aravinth41/ECG_BLE/01_Project Inputs/WhatsApp Image 2020-04-03 at 2.52.47 PM.jpeg

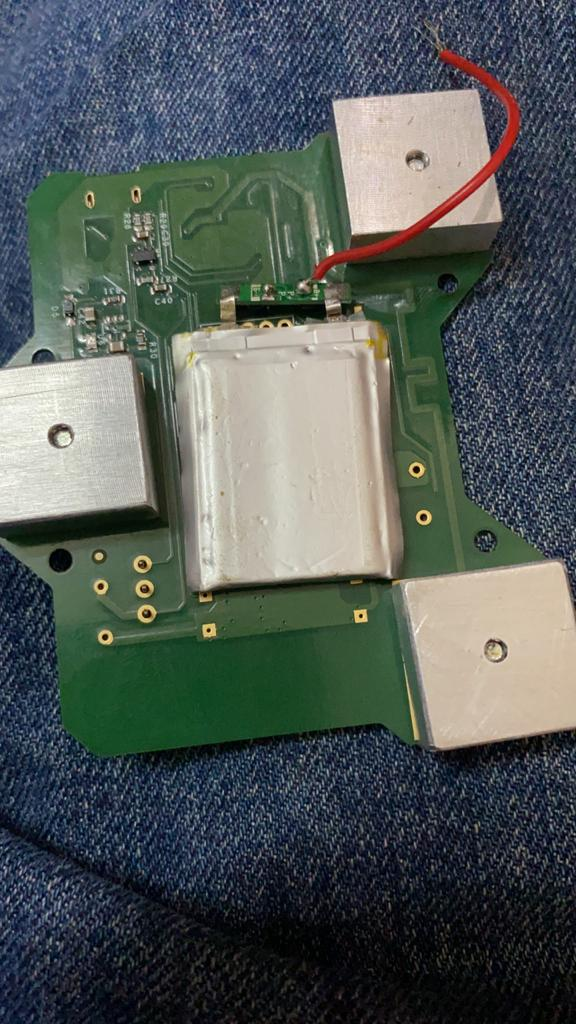
01_Project Inputs/WhatsApp Image 2020-04-03 at 2.52.47 PM.jpeg
