aravinth41/ECG_BLE/07_Mechanical/ECG BLE Mechanical requirement V10.pptx

## ECG BLE Mechanical Requirement

09-April-2020

## Old board design


PCB Bottom


PCB Top

## Old board design

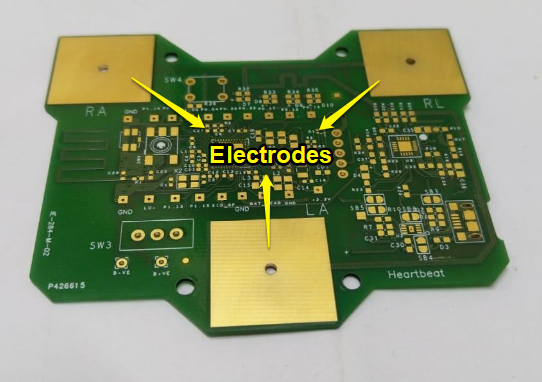
[picture p3: figure]
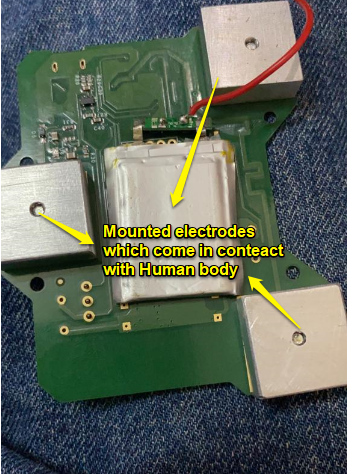
[picture p4: figure]

## New board requirement

PCB Diameter 42mm

## New board requirement

Note: Temperature sensor to be added and yet to plan
on the position.

PCB Diameter 42mm

Opening required for casing in
The dotted areas

## New board requirement

PCB Diameter 42mm

Opening for Micro B USB
Connector

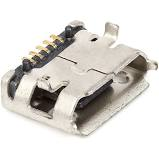
[picture p5: figure]

Note: Yet to decide on USB connector position

## New board requirement

PCB Diameter 42mm

3 Electrodes will be mounted in
the dotted region.
Something similar to this.

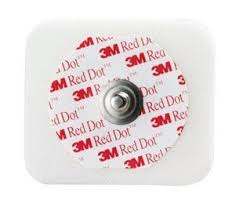
[picture p6: figure]

Note: Yet to decide the electrode part

## New board requirement

Bottom view

PCB

On board connector
PCB mount

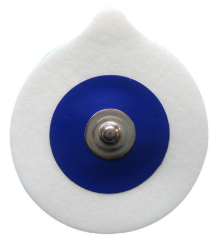
[picture p7: figure]

Note: Yet to decide the electrode part

Mating electrode

## New board requirement

Bottom view with no electrode mounted

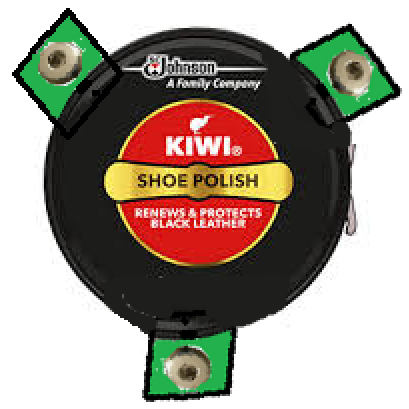
[picture p8: figure]

Over all product looks like a Shoe
Polish tin. Something like this with
the electrode stickers, which will
have contact with Human body.

Bottom view with electrode mounted

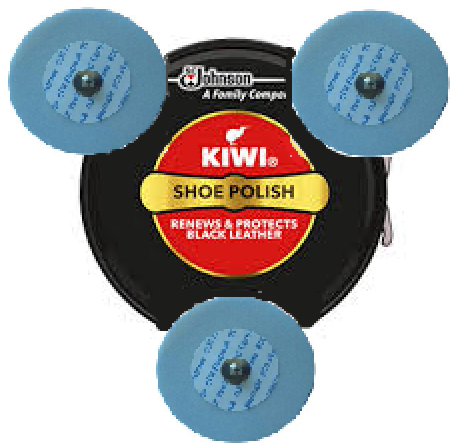
[picture p9: figure]

LA

LA

RA

RA

RL/LL

RL/LL
