aravinth41/ECG_BLE/03_Output/02_Assembly/ECG_BLE_Bill_Of_Materials_V1_PCBA.xlsx

Component list |  |  |  |  |  | Project: | ECG_BLE.PrjPcb
 |  |  | Board Name: | ECG_BLE.PCBA
 |  |  | Revision: | Rev1.0
 |  |  | Author: | Sandeep G
 |  |  | Report Date: | 08-May-20 | 2:30:41 AM
 |  |  | Print Date: | 2020-06-26 | 12:34:22
Item | Quantity | Designator | Description | Manufacturer | Manufacturer Part Number | Vendor Name | Vendor Part Number | Mouting State
1 | 2 | C1, C2 | CAP CER 0.33UF 10V X5R 0402 | Samsung Electro-Mechanics | CL05A334KP5NNNC | Digi-Key | 1276-6665-1-ND | Fitted
2 | 1 | C3 | CAP CER 1000PF 50V X7R 0402 | KEMET | C0402C102J5RACTU | Digi-Key | 399-7754-1-ND | Fitted
3 | 8 | C4, C5, C11, C12, C24, C25, C29, C35 | CAP CER 0.1UF 16V X7R 0402 | Samsung Electro-Mechanics America, Inc. | CL05B104KO5NNNC | Digi-Key | 1276-1001-1-ND | Fitted
4 | 1 | C6 | CAP CER 10000PF 50V X7R 0402 | Samsung Electro-Mechanics America, Inc. | C0402C103J5RACTU | Digi-Key | 399-7758-1-ND | Fitted
5 | 1 | C7 | CAP CER 1500PF 50V X7R 0402 | Yageo | CC0402JRX7R9BB152 | Digi-Key | 311-3763-1-ND | Fitted
6 | 4 | C9, C10, C30, C31 | CAP CER 1UF 16V X5R 0402 | Samsung Electro-Mechanics | CL05A105KO5NNNC | Digi-Key | 1276-1067-1-ND | Fitted
7 | 4 | C13, C14, C15, C17 | CAP CER 12PF 50V C0G/NP0 0402 | KEMET | CBR04C120J5GAC | Digi-Key | 399-6169-1-ND | Fitted
8 | 1 | C16 | CAP CER 100PF 25V C0G/NP0 0402 | KEMET | C0402C101J3GACTU | Digi-Key | 399-1022-1-ND | Fitted
9 | 2 | C19, C20 | CAP CER 1PF 50V C0G/NP0 0402 | Samsung Electro-Mechanics | CL05C010CB5NNNC | Digi-Key | 1276-1595-1-ND | Fitted
10 | 1 | C21 | CAP CER 820PF 50V C0G/NP0 0402 | Samsung Electro-Mechanics | CL05C821JB5NNNC | Digi-Key | 1276-1727-1-ND | Fitted
11 | 3 | C22, C23, C26 | CAP CER 4.7UF 6.3V X5R 0402 | Murata Electronics North America | GRM155R60J475ME47D | Digi-Key | 490-5915-1-ND | Fitted
12 | 2 | C27, C28 | CAP CER 10UF 10V X5R 0402 | Samsung Electro-Mechanics America, Inc. | CL05A106MP5NUNC | DigiKey | 1276-1450-1-ND | Fitted
13 | 1 | C32 | CAP CER 1.5PF 50V NP0 0402 | Murata Electronics | GJM1555C1H1R5CB01D‎ | Digi-Key | 490-3087-1-ND‎ | Fitted
14 | 1 | D1 | LED GREEN/RED CLEAR 1204 SMD R/A | Bivar Inc. | SM1204BC | Digi-Key | 492-1228-1-ND | Fitted
15 | 1 | D3 | LED BLUE CLEAR 2SMD | Kingbright | APT1608LVBC/D | Digi-Key | 754-1933-1-ND | Fitted
16 | 1 | D4 | LED GREEN CLEAR SMD | Würth Elektronik | 150060VS75000‎ | Digi-Key | ‎732-4980-1-ND‎ | Fitted
17 | 1 | J2 | CONN HOUSING PH 2POS 2MM WHITE | JST Sales America Inc. | S2B-PH-K-S(LF)(SN) | Digi-Key | 455-1719-ND | Fitted
18 | 1 | J3 | CONN USB MICRO B RECPT SMT R/A | Amphenol FCI | 10118194-0001LF | Digi-Key | 609-4618-1-ND | Fitted
19 | 1 | L1 | FIXED IND 3.9NH 170MA 500 MOHM | Murata Electronics North America | LQP15MN3N9B02D | Digi-Key | 490-1131-1-ND | Fitted
20 | 1 | R1 | RES 1.4M OHM 1% 1/16W 0402 | Stackpole Electronics Inc | RMCF0402FT1M40 | Digi-Key | RMCF0402FT1M40CT-ND | Fitted
21 | 6 | R2, R3, R4, R5, R9, R11 | RES SMD 10M OHM 5% 1/10W 0402 | Panasonic Electronic Components | ERJ-2GEJ106X | Digi-Key | P10MJCT-ND | Fitted
22 | 6 | R6, R12, R17, R19, R21, R38 | RES SMD 0.0OHM JUMPER 1/10W 0402 | Panasonic Electronic Components | ERJ-2GE0R00X | Digi-Key | P0.0JCT-ND | Fitted
23 | 2 | R7, R10 | RES SMD 180K OHM 1% 1/16W 0402 | Yageo | RC0402FR-07180KL | Digi-Key | 311-180KLRCT-ND | Fitted
24 | 1 | R13 | RES SMD 360K OHM 1% 1/10W 0402 | Panasonic Electronic Components | ERJ-2RKF3603X | Digi-Key | P360KLCT-ND | Fitted
25 | 3 | R15, R16, R20 | RES SMD 1M OHM 1% 1/10W 0402 | Panasonic Electronic Components | ERJ-2RKF1004X | Digi-Key | P1.00MLCT-ND | Fitted
26 | 3 | R18, R23, R30 | RES SMD 100K OHM 1% 1/10W 0402 | Panasonic Electronic Components | ERJ-2RKF1003X | Digi-Key | P100KLCT-ND | Fitted
27 | 2 | R24, R27 | RES SMD 10K OHM 1% 1/10W 0402 | Panasonic Electronic Components | ERJ-2RKF1002X | Digi-Key | P10.0KLCT-ND | Fitted
28 | 1 | R22 | RES SMD 4.7K OHM 5% 1/10W 0402 | Panasonic Electronic Components | ERJ-2GEJ472X | Digi-Key | P4.7KJCT-ND | Fitted
29 | 2 | R25, R26 | RES SMD 1.5K OHM 1% 1/10W 0402 | Panasonic Electronic Components | ERJ-2RKF1501X | Digi-Key | P1.50KLCT-ND | Fitted
30 | 1 | R28 | RES SMD 16.5K OHM 1% 1/10W 0402 | Panasonic Electronic Components | ERJ-2RKF1652X | Digi-Key | P16.5KLCT-ND | Fitted
31 | 1 | R29 | RES SMD 13.3K OHM 1% 1/10W 0402 | Panasonic Electronic Components | ERJ-2RKF1332X | Digi-Key | P13.3KLCT-ND | Fitted
32 | 1 | R31 | RES SMD 470 OHM 1% 1/10W 0402 | Panasonic Electronic Components | ERJ-2RKF4700X | Digi-Key | P470LCT-ND | Fitted
33 | 1 | R32 | RES SMD 1K OHM 1% 1/10W 0402 | Panasonic Electronic Components | ERJ-2RKF1001X | Digi-Key | P1.00KLCT-ND | Fitted
34 | 1 | SW1 | SWITCH SLIDE SPDT 200MA 12V | Nidec Copal Electronics | CL-SB-12A-11T | Digi-Key | 563-1316-1-ND | Fitted
35 | 1 | U1 | IC ECG FRONT END 20LFCSP | Analog Devices | AD8232ACPZ-WP | Digi-Key | AD8232ACPZ-WP-ND | Fitted
36 | 1 | U2 | IC RF TXRX+MCU 802.15.4 73VFQFN | Nordic Semiconductor ASA | NRF52840-QIAA-R | Digi-Key | 1490-1071-1-ND | Fitted
37 | 1 | U3 | 1.6A LINEAR LI-ION CHGR 10TDFN | Skyworks Solutions Inc. | AAT3693IDH-AA-T1 | Digi-Key | 863-1512-1-ND | Fitted
38 | 1 | U4 | IC REG LINEAR 3.3V 150MA SOT23-5 | Microchip Technology | MCP1711T-33I/OT |  | MCP1711T-33I/OTCT-ND | Fitted
39 | 1 | U5 | SENSOR ANALOG -40C-125C TO92-3 | Analog Devices Inc. | TMP36GT9Z | Digi-Key | TMP36GT9Z-ND | Fitted
40 | 1 | X1 | CRYSTAL 32.0000MHZ 8PF SMD | ECS Inc. | ECS-320-8-37CKM | Digi-Key | XC1547CT-ND | Fitted
41 | 1 | Y1 | CRYSTAL 32.7680KHZ 12.5PF SMD | Abracon LLC | ABS07-32.768KHZ-T | Digi-Key | 535-9542-1-ND | Fitted
DNP LIST
5 | 3 | TP1, TP2, TP3 | Test Point- 1.02mm Hole |  |  |  |  | Not Fitted
6 | 2 | C8, C18 | CAP CER 100PF 25V C0G/NP0 0402 | KEMET | DNP | Digi-Key | 399-1022-1-ND | Not Fitted
7 | 1 | C34 | CAP CER 2.2UF 10V JB 0402 | TDK Corporation | DNP | Digi-Key | 445-10904-1-ND | Not Fitted
8 | 6 | R8, R14, R35, R36, R37, R39 | RES SMD 0.0OHM JUMPER 1/10W 0402 | Panasonic Electronic Components | DNP | Digi-Key | P0.0JCT-ND | Not Fitted
9 | 1 | R33 | RES 45.3K OHM 0.5% 1/16W 0402 | Stackpole Electronics Inc | DNP | Digi-Key | RNCF0402DTE45K3CT-ND | Not Fitted
10 | 1 | R34 | RES SMD 10K OHM 0.5% 1/16W 0402 | Panasonic Electronic Components | DNP | Digi-Key | P15984CT-ND | Not Fitted
Approved |  | Vijay |  | Notes
