aravinth41/ECG_BLE/08_Others/Battery selection and comparison V10.xlsx

Sl No. | Battery Part Number | Battery Voltage | Charging Voltage | Battery Capacity | Battery dimension | Manufacturer
1 | 1578 | 3.7V | 4.2V | 500mAh | 29.0mm x 36.0mm x 4.8mm | Adafruit Industries LLC
2 | PRT-13854 | 3.7V | 4.2V | 850mAh | 43.0mm x 34.0mm x 6.2mm | SparkFun Electronics
3 | 2750 | 3.7V | 4.2V | 350mAh | 36.0mm x 20.0mm x 5.6mm | Adafruit Industries LLC
4 | ASR00007 | 3.7V | 4.2V | 290mAh | 23.9mm x 23.9mm x 5.8mm | TinyCircuits
5 | LP333437JU + PCM+ WIRES 50MM | 3.7V | 4.2V | 410mAh | 39.0mm x 34.0mm x 4.0mm | Jauch Quartz
6 | LP102530JU + PCM + WIRES 50MM | 3.7V | 4.2V | 680mAh | 32.0mm x 26.0mm x 11.0mm | Jauch Quartz
7 | ASR00035 | 3.7V | 4.2V | 500mAh | 31.0mm x 20.0mm x 9.5mm | TinyCircuits
8 | 3898 | 3.7V | 4.2V | 400mAh | 35.6mm x 15.2mm x 7.6mm | Adafruit Industries LLC
