aravinth41/ECG_BLE/08_Others/Draft of Board outline and component placement.png

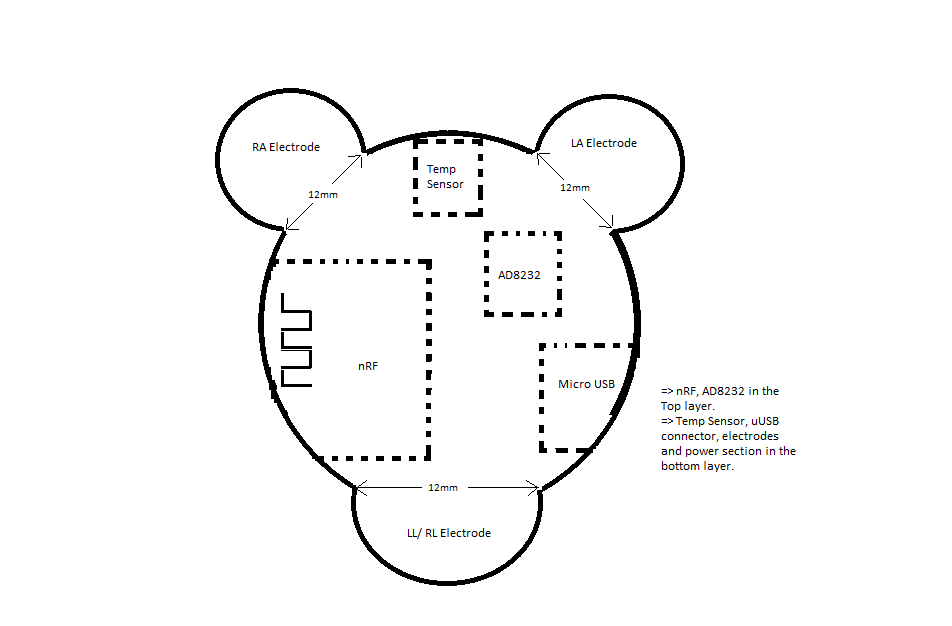
08_Others/Draft of Board outline and component placement.png
