aravinth41/ECG_BLE/01_Project Inputs/Schematic_nrf52 schematics_Sheet_1_20191210113403.pdf

A | A

1

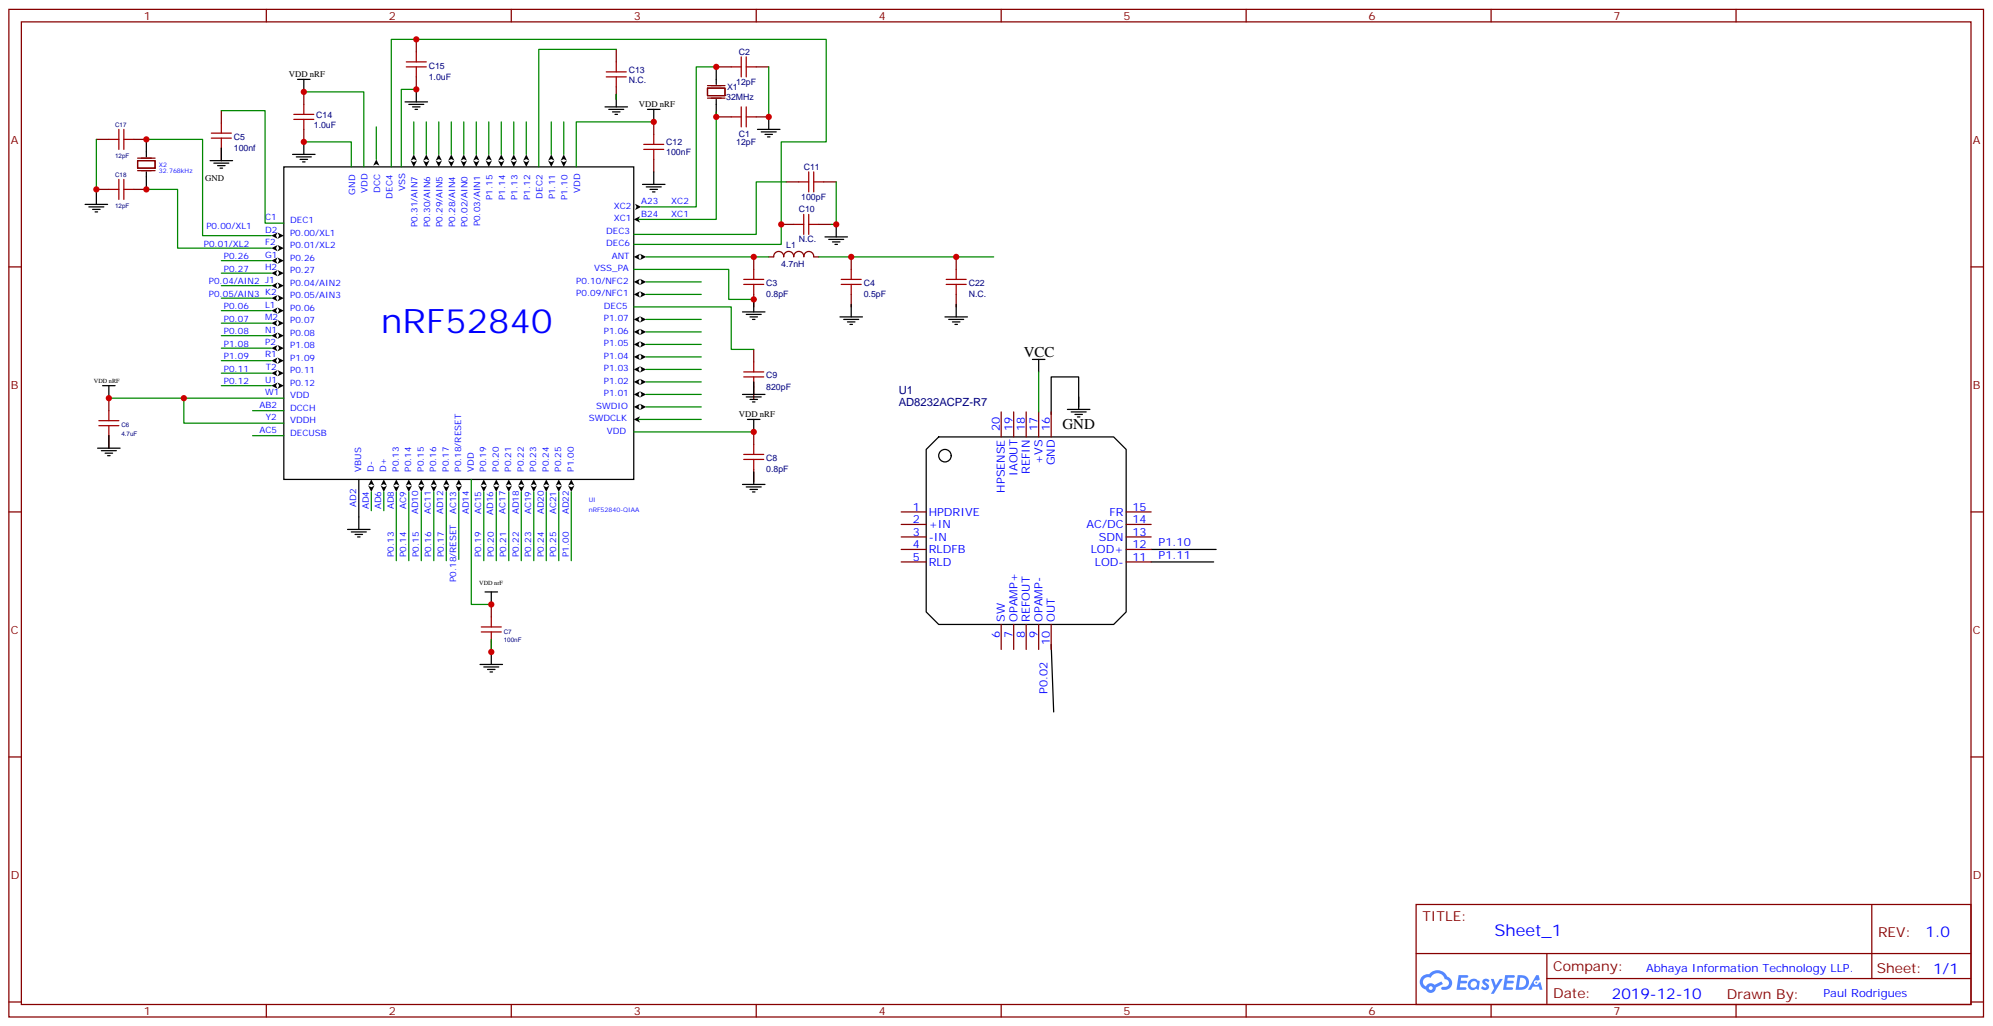
[picture p11: page 1]

GND 16 +VS 17 REFIN 18 IAOUT 19 HPSENSE 20

LOD- 11 LOD+ 12 SDN 13 AC/DC 14 FR 15

Abhaya Information Technology LLP.
