aravinth41/ECG_BLE/02_Design/E2S-ABH-010V1_Schematic PDF.pdf

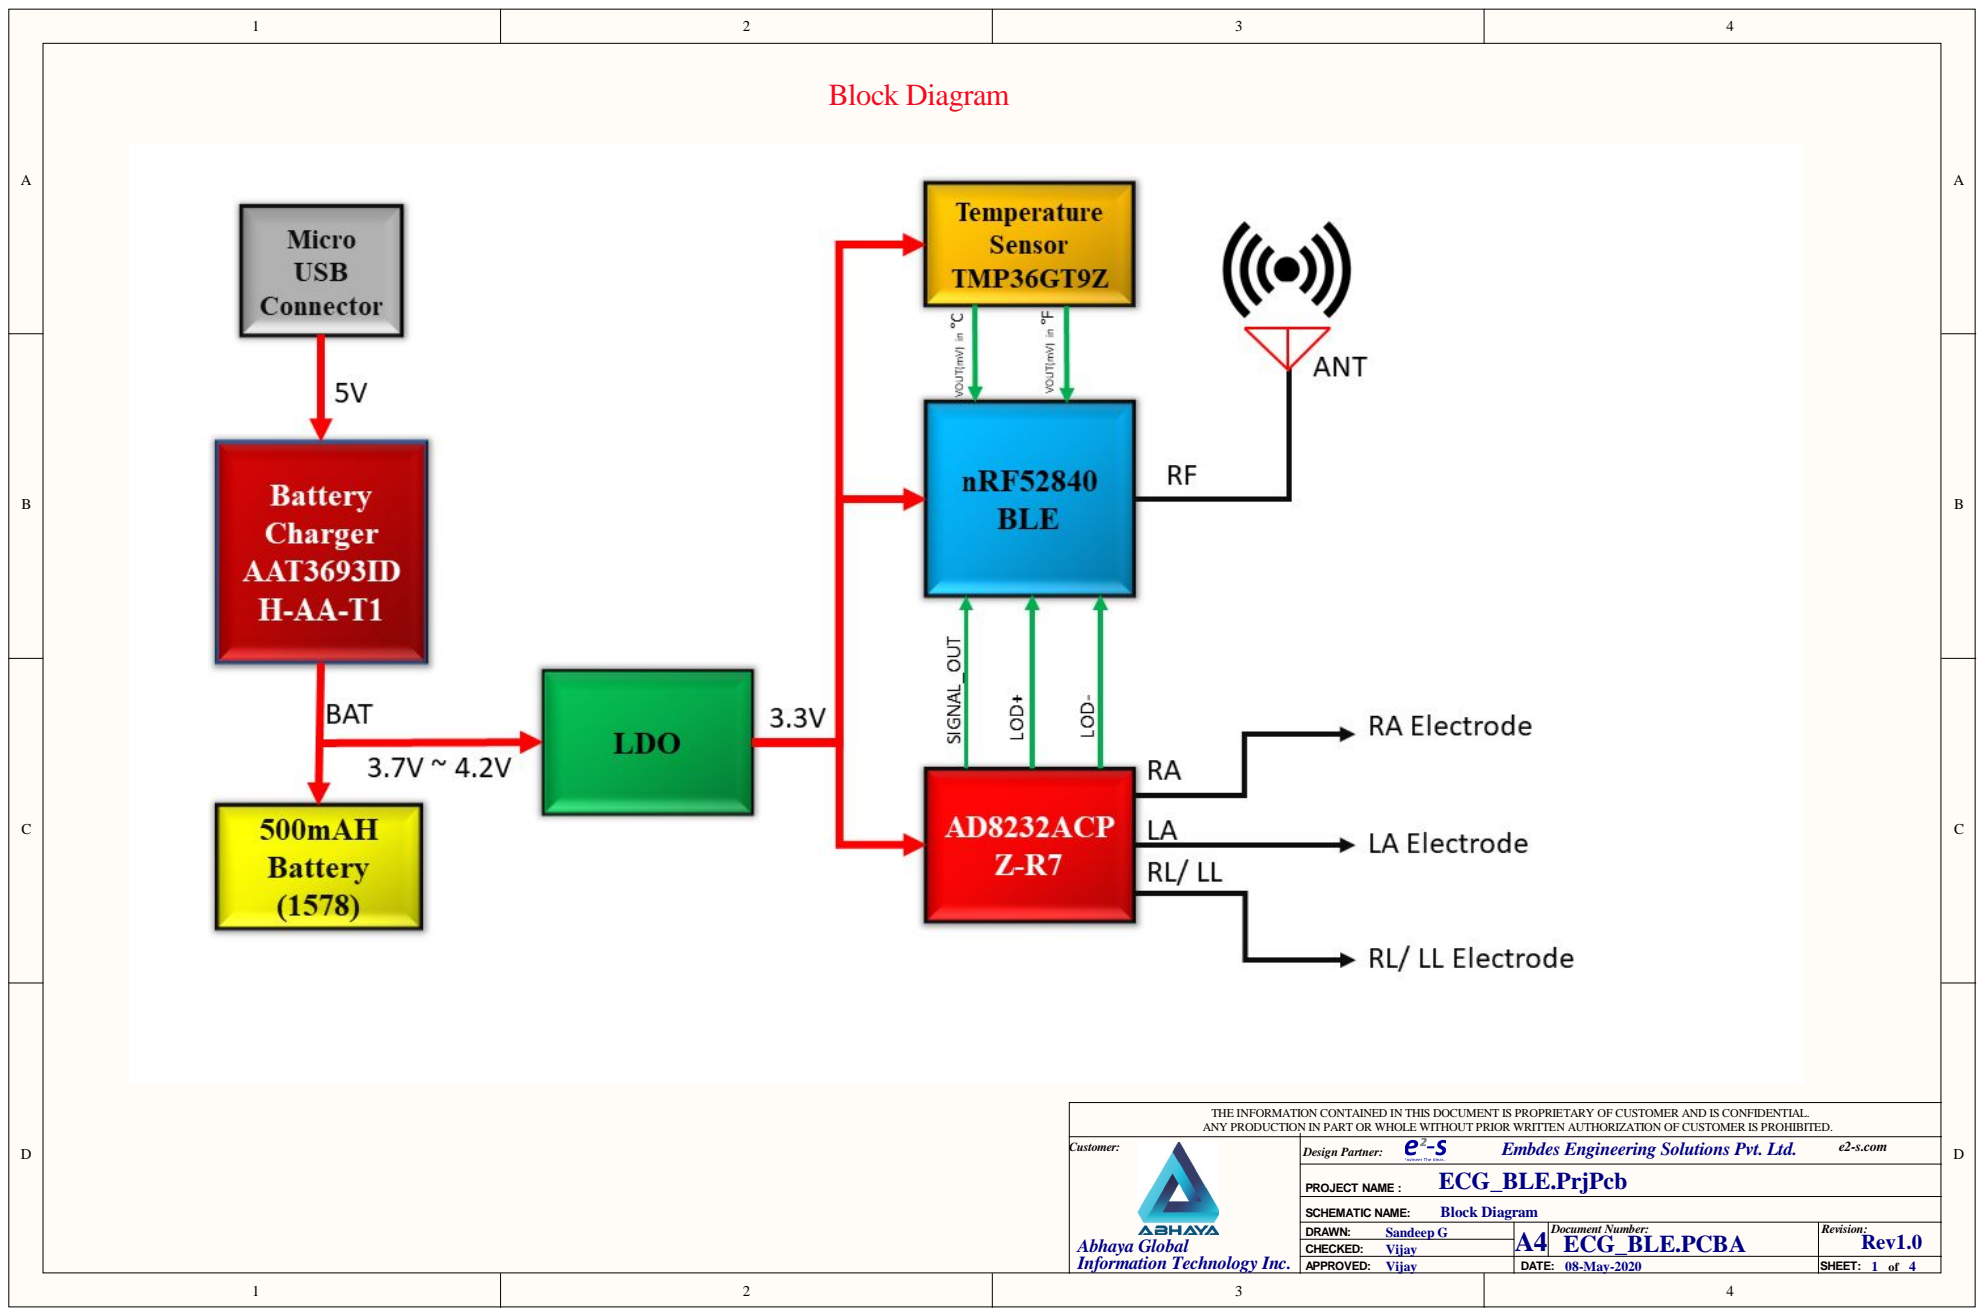
[picture p12: page 1]

THE INFORMATION CONTAINED IN THIS DOCUMENT IS PROPRIETARY OF CUSTOMER AND IS CONFIDENTIAL.
ANY PRODUCTION IN PART OR WHOLE WITHOUT PRIOR WRITTEN AUTHORIZATION OF CUSTOMER IS PROHIBITED.

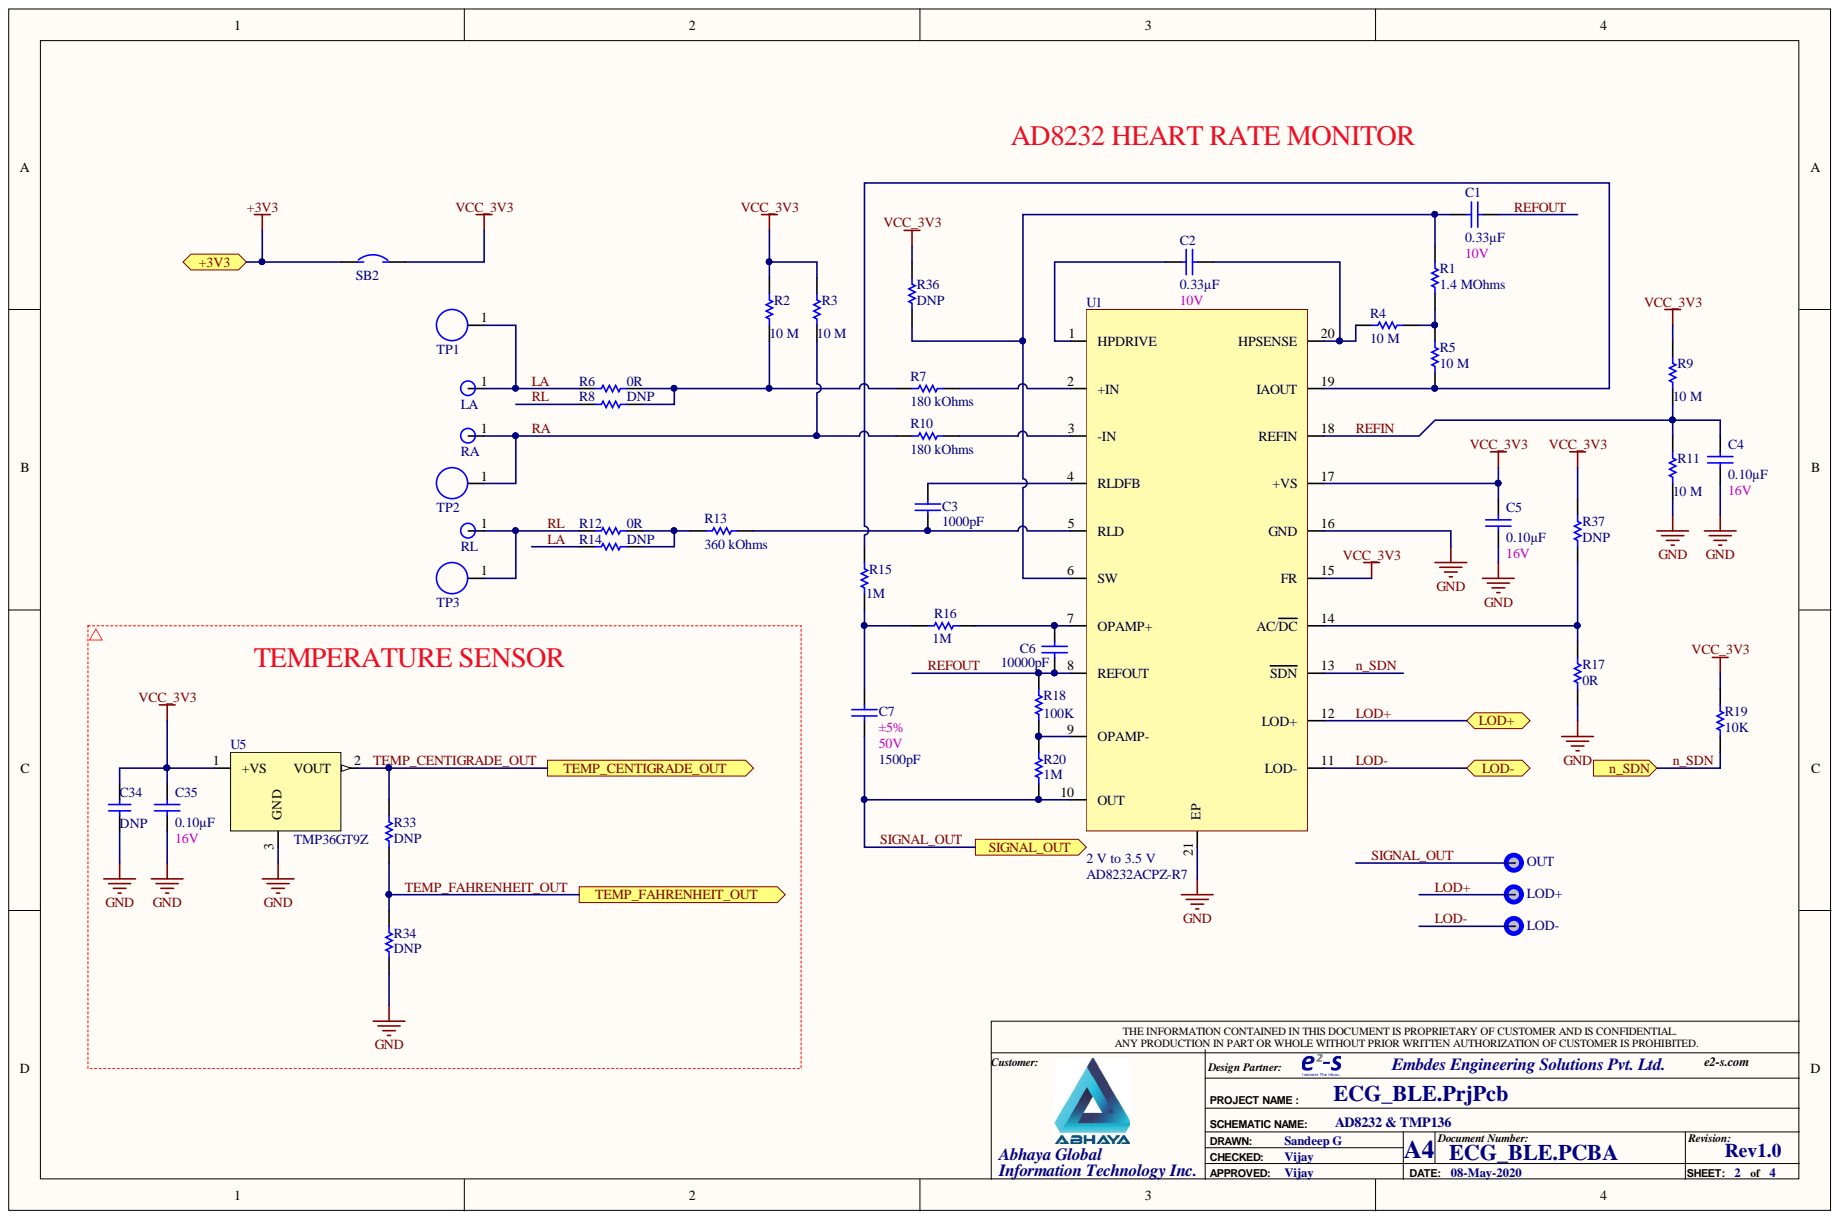
[picture p13: page 2]

5 | R LDF B +VS R LD GND S W F R OP AM P + A C/DC REFOUT SDN LOD+ OP AM P -LOD-OUT | 1 6

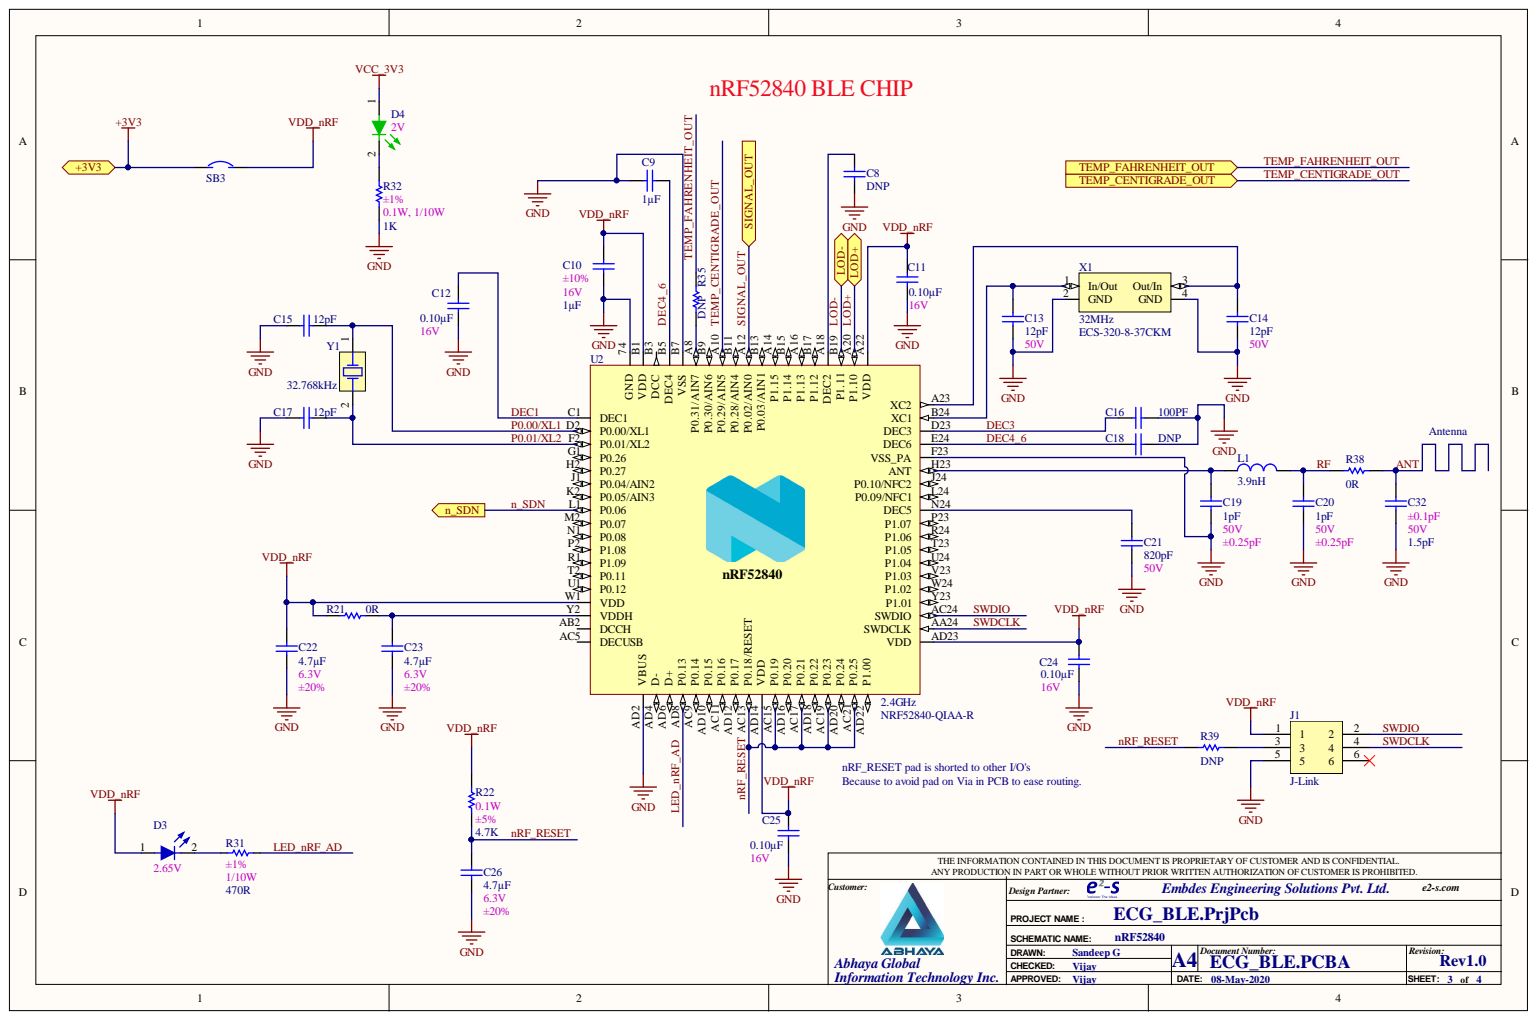
[picture p14: page 3]

R21 0R | VDDH Y2

nRF_RESET pad is shorted to other I/O's
Because to avoid pad on Via in PCB to ease routing.

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

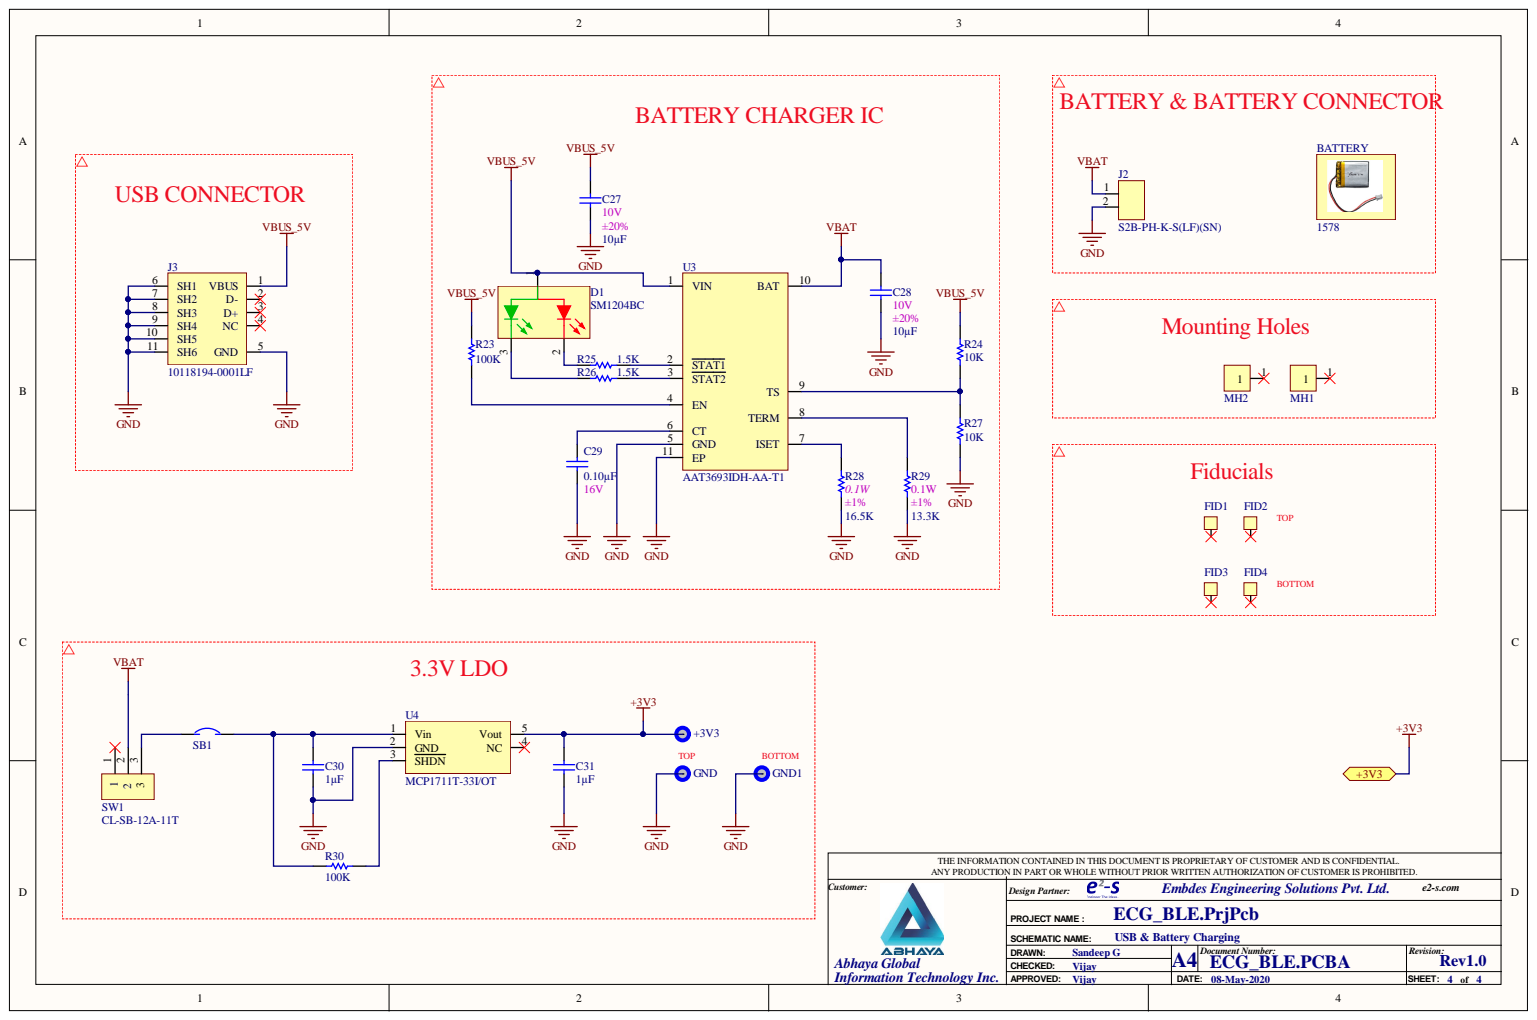
[picture p15: page 4]
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
