aravinth41/ECG_BLE/03_Output/02_Assembly/ECG_BLE_V1_ASSEMBLY_DWG.PDF

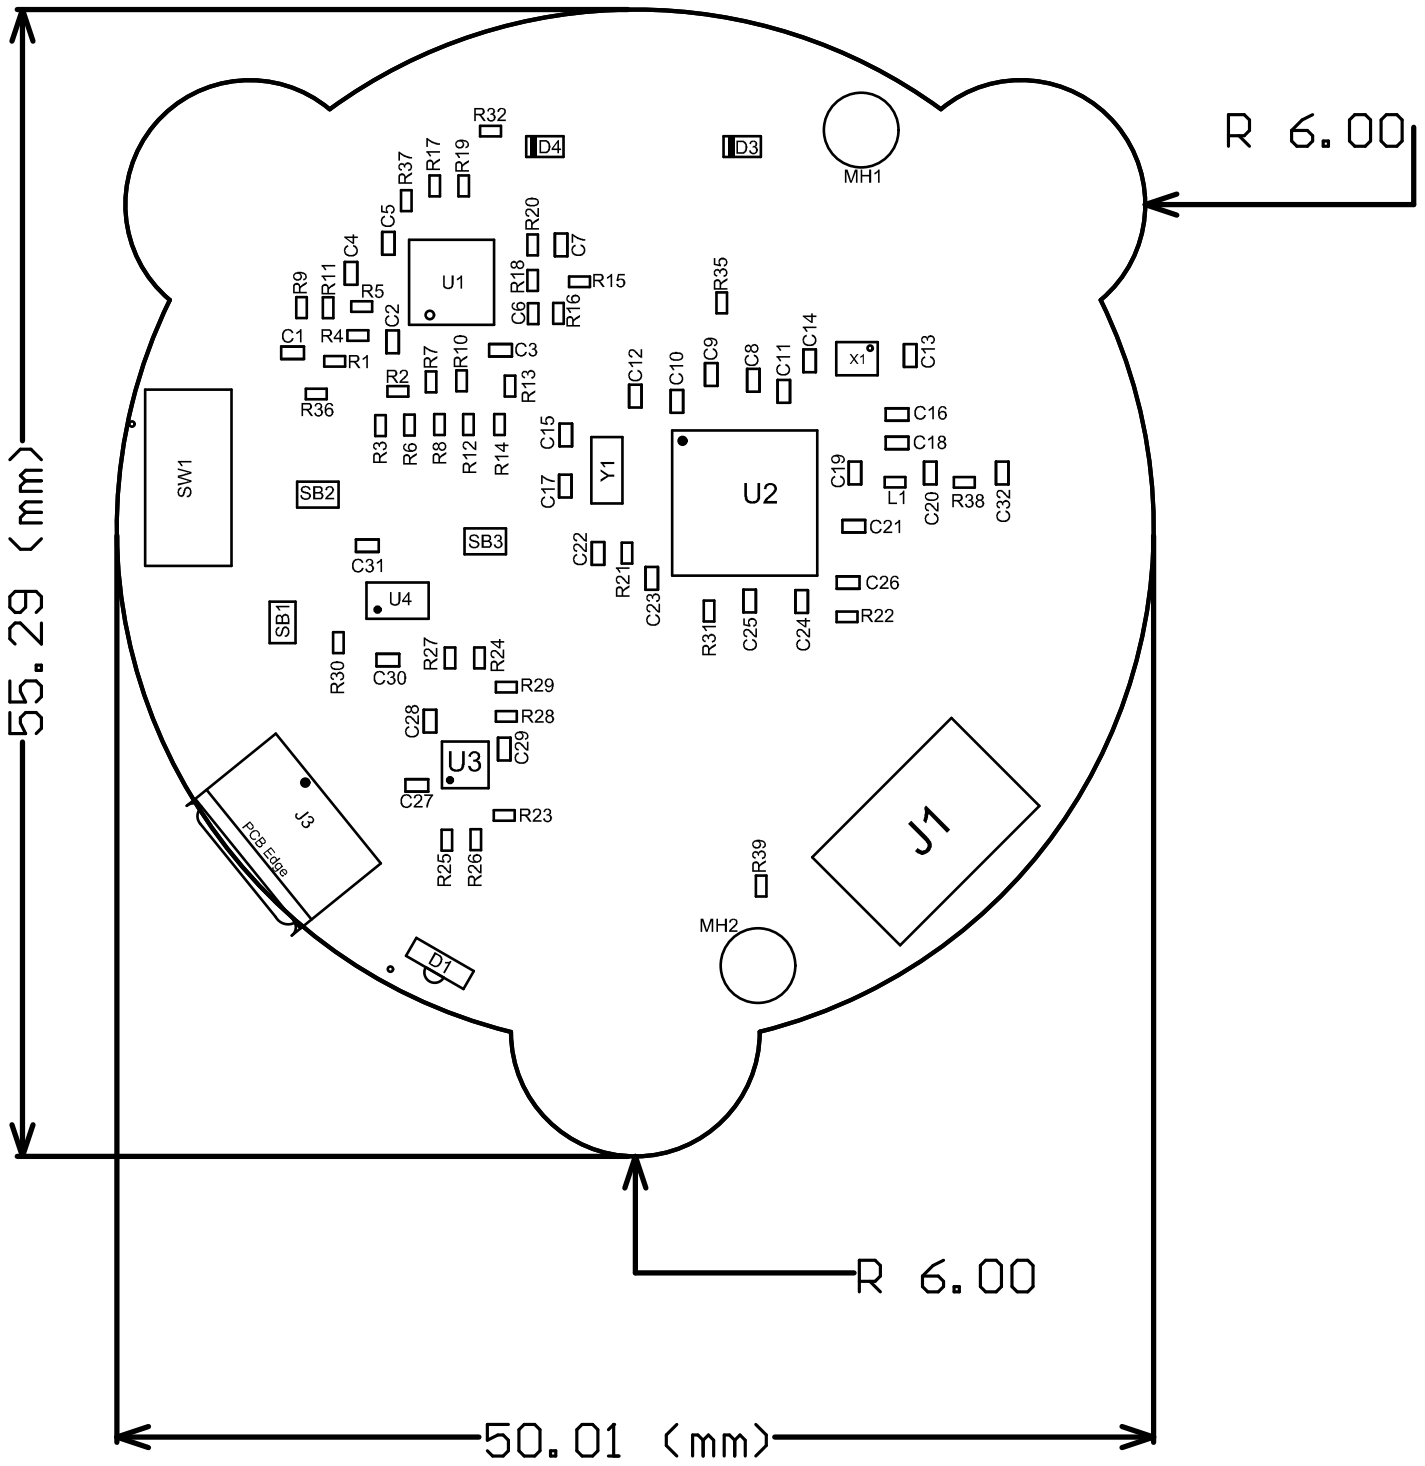
[picture p16: page 1]

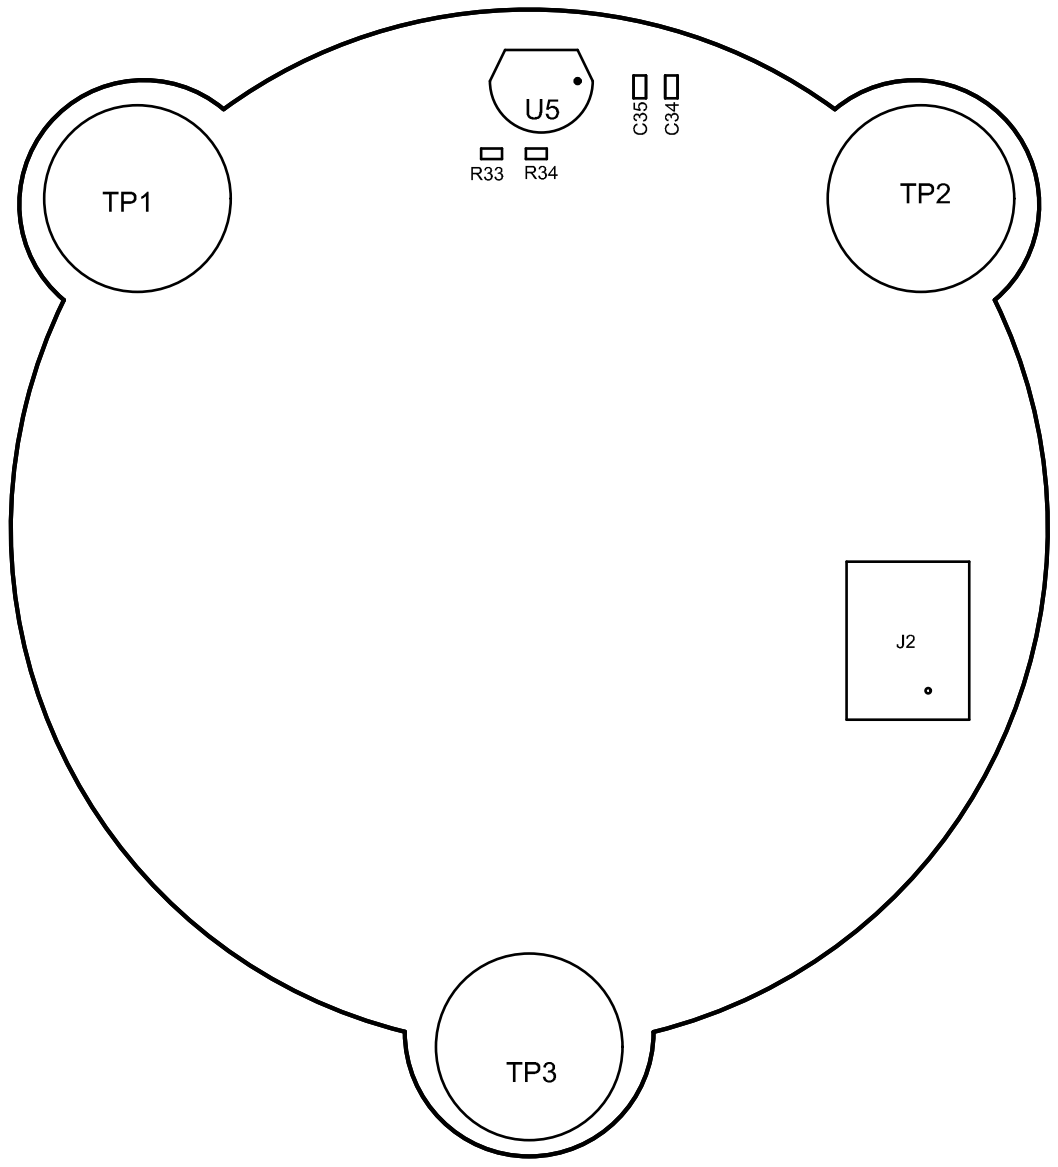
[picture p17: page 2]
