aravinth41/ECG_BLE/(list of files, drawings)

Other design files:
02_Design/AD8232 & TMP136.SchDoc
02_Design/Block Diagram.SchDoc
02_Design/ECG_BLE.PcbDoc
02_Design/ECG_BLE.PrjPcb
02_Design/nRF52840.SchDoc
02_Design/USB & Battery Charging.SchDoc
