aravinth41/ECG_BLE/(commit log)

2020-04-06 Project plan for ECG_BLE project
    Project plan for ECG_BLE project
    [ECG_BLE_Plan_V10.xlsx]
2020-04-08 Updated Battery selection sheet and nRF52840 reference design
    Comaprision of Battery with different make and capacity. Added reference design for nrf52840 Dongle and development board
    [Battery selection and comparison V10.xlsx]
2020-04-12 Latest design files and mechanical document
    Updated design files and mechanical requirement document is updated.
    [AD8232.SchDoc, ECG_BLE.PrjPcb, ECG_BLE.SchLib, USB & Battery Charging.SchDoc, nRF52840.SchDoc]
2020-04-14 Latest design files
    Latest udpated design files as on 14 April 2020
    [ECG_BLE.PrjPcb, ECG_BLE.SchLib, USB & Battery Charging.SchDoc, nRF52840.SchDoc]
2020-04-15 Latest design files
    Updated latest design files as on 15-Apr-2020
    [AD8232 & TMP136.SchDoc, AD8232.SchDoc, ECG_BLE.PcbDoc, ECG_BLE.PrjPcb, ECG_BLE.SchLib, USB & Battery Charging.SchDoc, nRF52840.SchDoc]
2020-04-16 Latest files as on 16 April 2020
    Latest Updated PCB files as on 16 Apr 2020
    [ECG_BLE.PcbDoc]
2020-04-17 Latest files as on 17 Apr 2020
    Updated Latest project files
    [AD8232 & TMP136.SchDoc, Block Diagram.SchDoc, ECG_BLE.PcbDoc, ECG_BLE.PrjPcb]
2020-04-20 Latest files as on 20-Apr 2020
    Updated Sch and sch pdf as on 20 april
    [AD8232 & TMP136.SchDoc, ECG_BLE.PrjPcb, ECG_BLE.SchLib, USB & Battery Charging.SchDoc, nRF52840.SchDoc]
2020-04-23 PCB_Design file
2020-04-29 Latest PCB File
2020-04-30 PCB latest file 30-04-2020
2020-05-02 Latest 3DPDF, STEP, and PCB file-02-05-2020
2020-05-08 Final Design files through which Fabrication Gerbers were released
    Removed all old design files and added final files with adddition of LED, switch as per Vijay sir comments.
    [AD8232 & TMP136.SchDoc, Block Diagram.SchDoc, ECG_BLE.PcbDoc, ECG_BLE.PrjPcb, ECG_BLE.SchLib, USB & Battery Charging.SchDoc, nRF52840.SchDoc]
2020-05-08 Final Gerbers and BOM shared to Tarak for V1 fabrication
    Updated and reviewed final files that were shared to client
    [E2S-ABH-010V1.DRL, E2S-ABH-010V1.GBL, E2S-ABH-010V1.GBO, E2S-ABH-010V1.GBP, E2S-ABH-010V1.GBS, E2S-ABH-010V1.GTL, E2S-ABH-010V1.GTO, E2S-ABH-010V1.GTP]
2020-05-11 Updated PCB with Assembly drawing alligned
    Assembly refdes is updated with the final files and this is the final PCB with updated assembly refdes
    [ECG_BLE.PcbDoc]
2020-06-26 Updated BOM with R19 to 0R to make the board work
    R19 updated to 0 ohms as AD8232 was in Shut down mode to make it High and working R19 is made 0 ohms. R19 can be 10K again when code is updated
    [ECG_BLE_Bill_Of_Materials_V1.1.xlsx]
2020-06-26 Pick and place, assembly drawing and Gerber paste layers added for ECG_BLE project
    Pick and place, assembly drawing and Gerber paste layers added for ECG_BLE project
    [ECG_BLE_Bill_Of_Materials_V1_PCBA.xlsx, Pick Place for ECG_BLE.csv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]
2020-07-20 Added Schematic PDF file for ECG BLE V1
    Schematic PDF for ECG BLE V1
